licheegh/LCSDR/README.md

# LCSDR

more at <http://www.squirrel-electronics.com/lcsdrgong-cheng.html>
