licheegh/LCSDR/hardware/main/bom.ods

Qty | Reference(s) | Footprint | LibPart | Value | Source
24 | C201, C202, C208, C210, C211, C212, C213, C214, C215, C305, C306, C307, C317, C325, C402, C406, C407, C414, C415, C505, C511, C514, C516, C518 | Resistors_SMD:R_0805 | device:C | 4.7u
11 | C203, C204, C205, C206, C207, C222, C223, C411, C412, C416, C422 | Capacitors_SMD:C_1206 | device:C | 22u
57 | C209, C216, C217, C218, C219, C220, C221, C224, C225, C226, C227, C228, C229, C230, C301, C302, C303, C304, C308, C309, C310, C311, C314, C316, C318, C319, C320, C321, C322, C323, C324, C401, C403, C404, C405, C408, C413, C419, C423, C424, C501, C507, C508, C509, C510, C512, C513, C515, C517, C519, C520, C521, C522, C523, C524, C525, C526 | Capacitors_SMD:C_0402 | device:C | 0.47u
2 | C409, C410 | Capacitors_SMD:c_elec_6.3x5.8 | device:CP | 47u
2 | C420, C421 | Resistors_SMD:R_0805 | device:C | 0.1u
2 | C502, C503 | Resistors_SMD:R_0805 | device:C | 12p
2 | C504, C527 | Capacitors_SMD:C_1206 | device:C | 4.7n 250V
1 | C506 | Capacitors_Elko_ThroughHole:Elko_vert_11.5x8mm_RM3.5 | device:CP | 470u
2 | D201, D202 | Diodes_SMD:SMA_Standard | device:D_Schottky | D_Schottky
4 | D301, D401, D502, D503 | LEDs:LED-0805 | device:LED | LED
1 | D501 | Diodes_SMD:SMA_Standard | device:TVS | TVS
1 | DD501 | Housings_SSOP:SSOP-56_7.5x18.5mm_Pitch0.635mm | active_components_lib:IC_CY7C68013A | IC_CY7C68013A
3 | FB201, FB202, FB501 | Resistors_SMD:R_0805 | device:FILTER | FILTER
4 | FB401, FB402, FB403, FB502 | Resistors_SMD:R_0805 | device:FILTER | FB
1 | J1 | my:5PIN_3.5mm_Audio_Jack_Wide | my:JACK_TRS_5PINS | JACK_TRS_5PINS
3 | JP501, JP502, JP503 | Pin_Headers:Pin_Header_Straight_1x02 | device:JUMPER | JUMPER
2 | L201, L202 | Choke_SMD:Choke_SMD_6.3x6.3_H3 | device:INDUCTOR | INDUCTOR
4 | M401, M402, M403, M404 | my:Mounting_Hole_3mm | my:Mount_Hole | Mount_Hole
1 | P401 | Socket_Strips:Socket_Strip_Straight_2x07 | conn:CONN_02X07 | CONN_02X07
1 | P402 | Socket_Strips:Socket_Strip_Angled_2x13 | conn:CONN_02X13 | CONN_02X13
2 | P501, P502 | my:USB_Micro-B | conn:USB_OTG | USB_OTG
8 | R201, R202, R301, R302, R303, R502, R503, R506 | Resistors_SMD:R_0805 | device:R | 100k
6 | R203, R204, R205, R206, R504, R505 | Resistors_SMD:R_0805 | device:R | 10k
13 | R207, R208, R210, R211, R304, R402, R403, R404, R406, R407, R408, R409, R412 | Resistors_SMD:R_0402 | device:R | 0
5 | R305, R307, R308, R309, R310 | Resistors_SMD:R_0805 | device:R | 2.4k
5 | R306, R401, R510, R511, R513 | Resistors_SMD:R_0805 | device:R | 560
1 | R405 | Resistors_SMD:R_0805 | device:R | 50
2 | R410, R411 | Resistors_SMD:R_0805 | device:R | 4.7
3 | R501, R512, R514 | Resistors_SMD:R_0805 | device:R | 1Meg
2 | R507, R508 | Resistors_SMD:R_0805 | device:R | 2.2k
1 | R509 | Resistors_SMD:R_0805 | device:R | 20k
1 | RV401 | my:RK09L12 | my:DUAL_POT_WITH_SHIELD | DUAL_POT_WITH_SHIELD
1 | S401 | my:EC11B15242A | my:Encoder_with_swith | Encoder_with_swith
2 | SW401, SW501 | my:SW_SPST_FSMSM | device:SW_PUSH | SW_PUSH
2 | U201, U202 | TO_SOT_Packages_SMD:SOT-23-5 | my:LMR10515-SOT23 | LMR10515-SOT23
1 | U203 | my:BGA-256_pitch1mm_dia0.4mm | xilinx-spartan6:XC6SLX25-FTG256 | XC6SLX25-FTG256
2 | U204, U205 | TO_SOT_Packages_SMD:SOT-223 | my:General_SOT223_LDO | General_SOT223_LDO
1 | U301 | Housings_QFP:LQFP-64_7x7mm_Pitch0.4mm | my:AD92x8 | AD92x8
1 | U302 | Housings_SOIC:SOIJ-8_5.3x5.3mm_Pitch1.27mm | my:25_Serial_Flash_8_Pin | 25_Serial_Flash_8_Pin
3 | U401, U402, U403 | TO_SOT_Packages_SMD:SOT-23-5 | 74xx:74AHC1G04 | 74AHC1G04
1 | U404 | Housings_SSOP:SSOP-16_4.4x5.2mm_Pitch0.65mm | my:UDA1334 | UDA1334
1 | U405 | Housings_DIP:DIP-8_W7.62mm | my:TDA2822M | TDA2822M
1 | U406 | Housings_SOIC:SOIC-8_3.9x4.9mm_Pitch1.27mm | my:MCP3202 | MCP3202
1 | U407 | Housings_SOIC:SOIC-8_3.9x4.9mm_Pitch1.27mm | my:MCP48x2 | MCP48x2
1 | U501 | Housings_SOIC:SOIC-8_3.9x4.9mm_Pitch1.27mm | memory:24C16 | 24C16
1 | X401 | my:oscillator_4Pin_5032_7050 | my:4-Pin_Oscillator | 4-Pin_Oscillator
1 | Y501 | Crystals:Crystal_HC49-U_Vertical | device:Crystal | Crystal
