licheegh/LCSDR/hardware/main/main.kicad_pcb

## KiCad design hardware/main/main.kicad_pcb (2015-11-01)

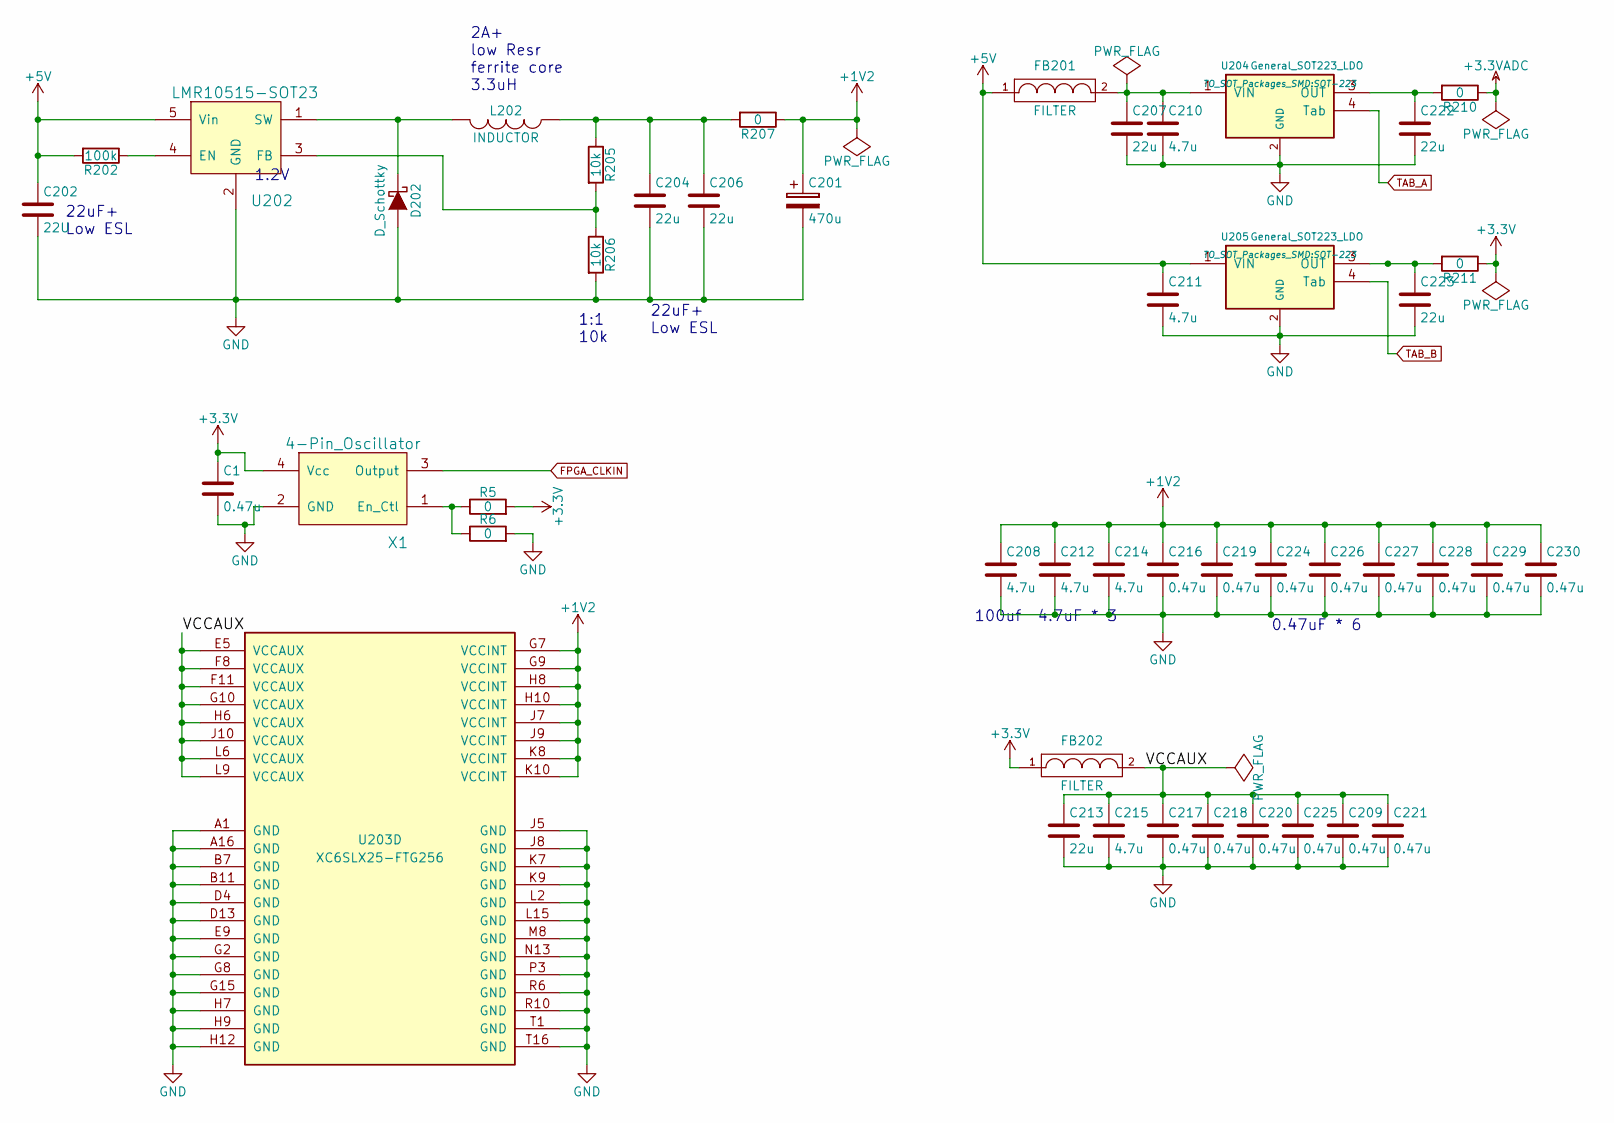
[picture p1: schematic PSU.sch]

Parts:
C1, C209, C216, C217, C218, C219, C220, C221, C224, C225, C226, C227, C228, C229, C230: 0.47u; C_0402
C201: 470u; Elko_vert_11.5x8mm_RM3.5
C202: 22U; C_1206
C204, C206, C207, C213, C222, C223: 22u; C_1206
C208, C210, C211, C212, C214, C215: 4.7u; R_0805
D202: D_Schottky; SMB_Standard
FB201, FB202: FILTER; R_0805
L202: INDUCTOR; Choke_SMD_6.3x6.3_H3
R5, R6: 0; R_0402
R202: 100k; R_0805
R205, R206: 10k; R_0805
R207, R210, R211: 0; R_0805
U202: LMR10515-SOT23; SOT-23-5
U203: XC6SLX25-FTG256; BGA-256_pitch1mm_dia0.4mm
U204, U205: General_SOT223_LDO; SOT-223
X1: 4-Pin_Oscillator; oscillator_4Pin_5032_7050

Connections:
+1V2: C201.1, C208.1, C212.1, C214.1, C216.1, C219.1, C224.1, C226.1, C227.1, C228.1, C229.1, C230.1, R207.1, U203.G7 (VCCINT), U203.G9 (VCCINT), U203.H8 (VCCINT), U203.H10 (VCCINT), U203.J7 (VCCINT), U203.J9 (VCCINT), U203.K8 (VCCINT), U203.K10 (VCCINT)
+3.3VADC: R210.1; also elsewhere on the board
+3V3: C1.1, FB202.1, R5.2, R211.1, X1.4 (Vcc); also elsewhere on the board
+5V: C202.1, C211.1, FB201.1, R202.2, U202.5 (Vin), U205.1 (VIN); also elsewhere on the board
/PSU/VCCAUX: C209.1, C213.1, C215.1, C217.1, C218.1, C220.1, C221.1, C225.1, FB202.2, U203.E5 (VCCAUX), U203.F8 (VCCAUX), U203.F11 (VCCAUX), U203.G10 (VCCAUX), U203.H6 (VCCAUX), U203.J10 (VCCAUX), U203.L6 (VCCAUX), U203.L9 (VCCAUX)
FPGA_CLKIN: X1.3 (Output); also elsewhere on the board
GND: C1.2, C201.2, C202.2, C204.2, C206.2, C207.2, C208.2, C209.2, C210.2, C211.2, C212.2, C213.2, C214.2, C215.2, C216.2, C217.2, C218.2, C219.2, C220.2, C221.2, C222.2, C223.2, C224.2, C225.2, C226.2, C227.2, C228.2, C229.2, C230.2, D202.2 (A), R6.2, R206.2, U202.2 (GND), U203.A1 (GND), U203.A16 (GND), U203.B7 (GND), U203.B11 (GND), U203.D4 (GND), U203.D13 (GND), U203.E9 (GND), U203.G2 (GND), U203.G8 (GND), U203.G15 (GND), U203.H7 (GND), U203.H9 (GND), U203.H12 (GND), U203.J5 (GND), U203.J8 (GND), U203.K7 (GND), U203.K9 (GND), U203.L2 (GND), U203.L15 (GND), U203.M8 (GND), U203.N13 (GND), U203.P3 (GND), U203.R6 (GND), U203.R10 (GND), U203.T1 (GND), U203.T16 (GND), U204.2 (GND), U205.2 (GND), X1.2 (GND); also elsewhere on the board
unnamed: C204.1, C206.1, L202.1, R205.1, R207.2
unnamed: C207.1, C210.1, FB201.2, U204.1 (VIN)
unnamed: C222.1, R210.2, U204.3 (OUT)
unnamed: C223.1, R211.2, U205.3 (OUT)
unnamed: D202.1 (K), L202.2, U202.1 (SW)
unnamed: R5.1, R6.1, X1.1 (En_Ctl)
unnamed: R202.1, U202.4 (EN)
unnamed: R205.2, R206.1, U202.3 (FB)
TAB_A: U204.4 (Tab)
TAB_B: U205.4 (Tab)

Notes on the sheet:
1.2V
2A+ low Resr ferrite core 3.3uH
22uF+ Low ESL
1:1 10k
100uf
4.7uF * 3
0.47uF * 6

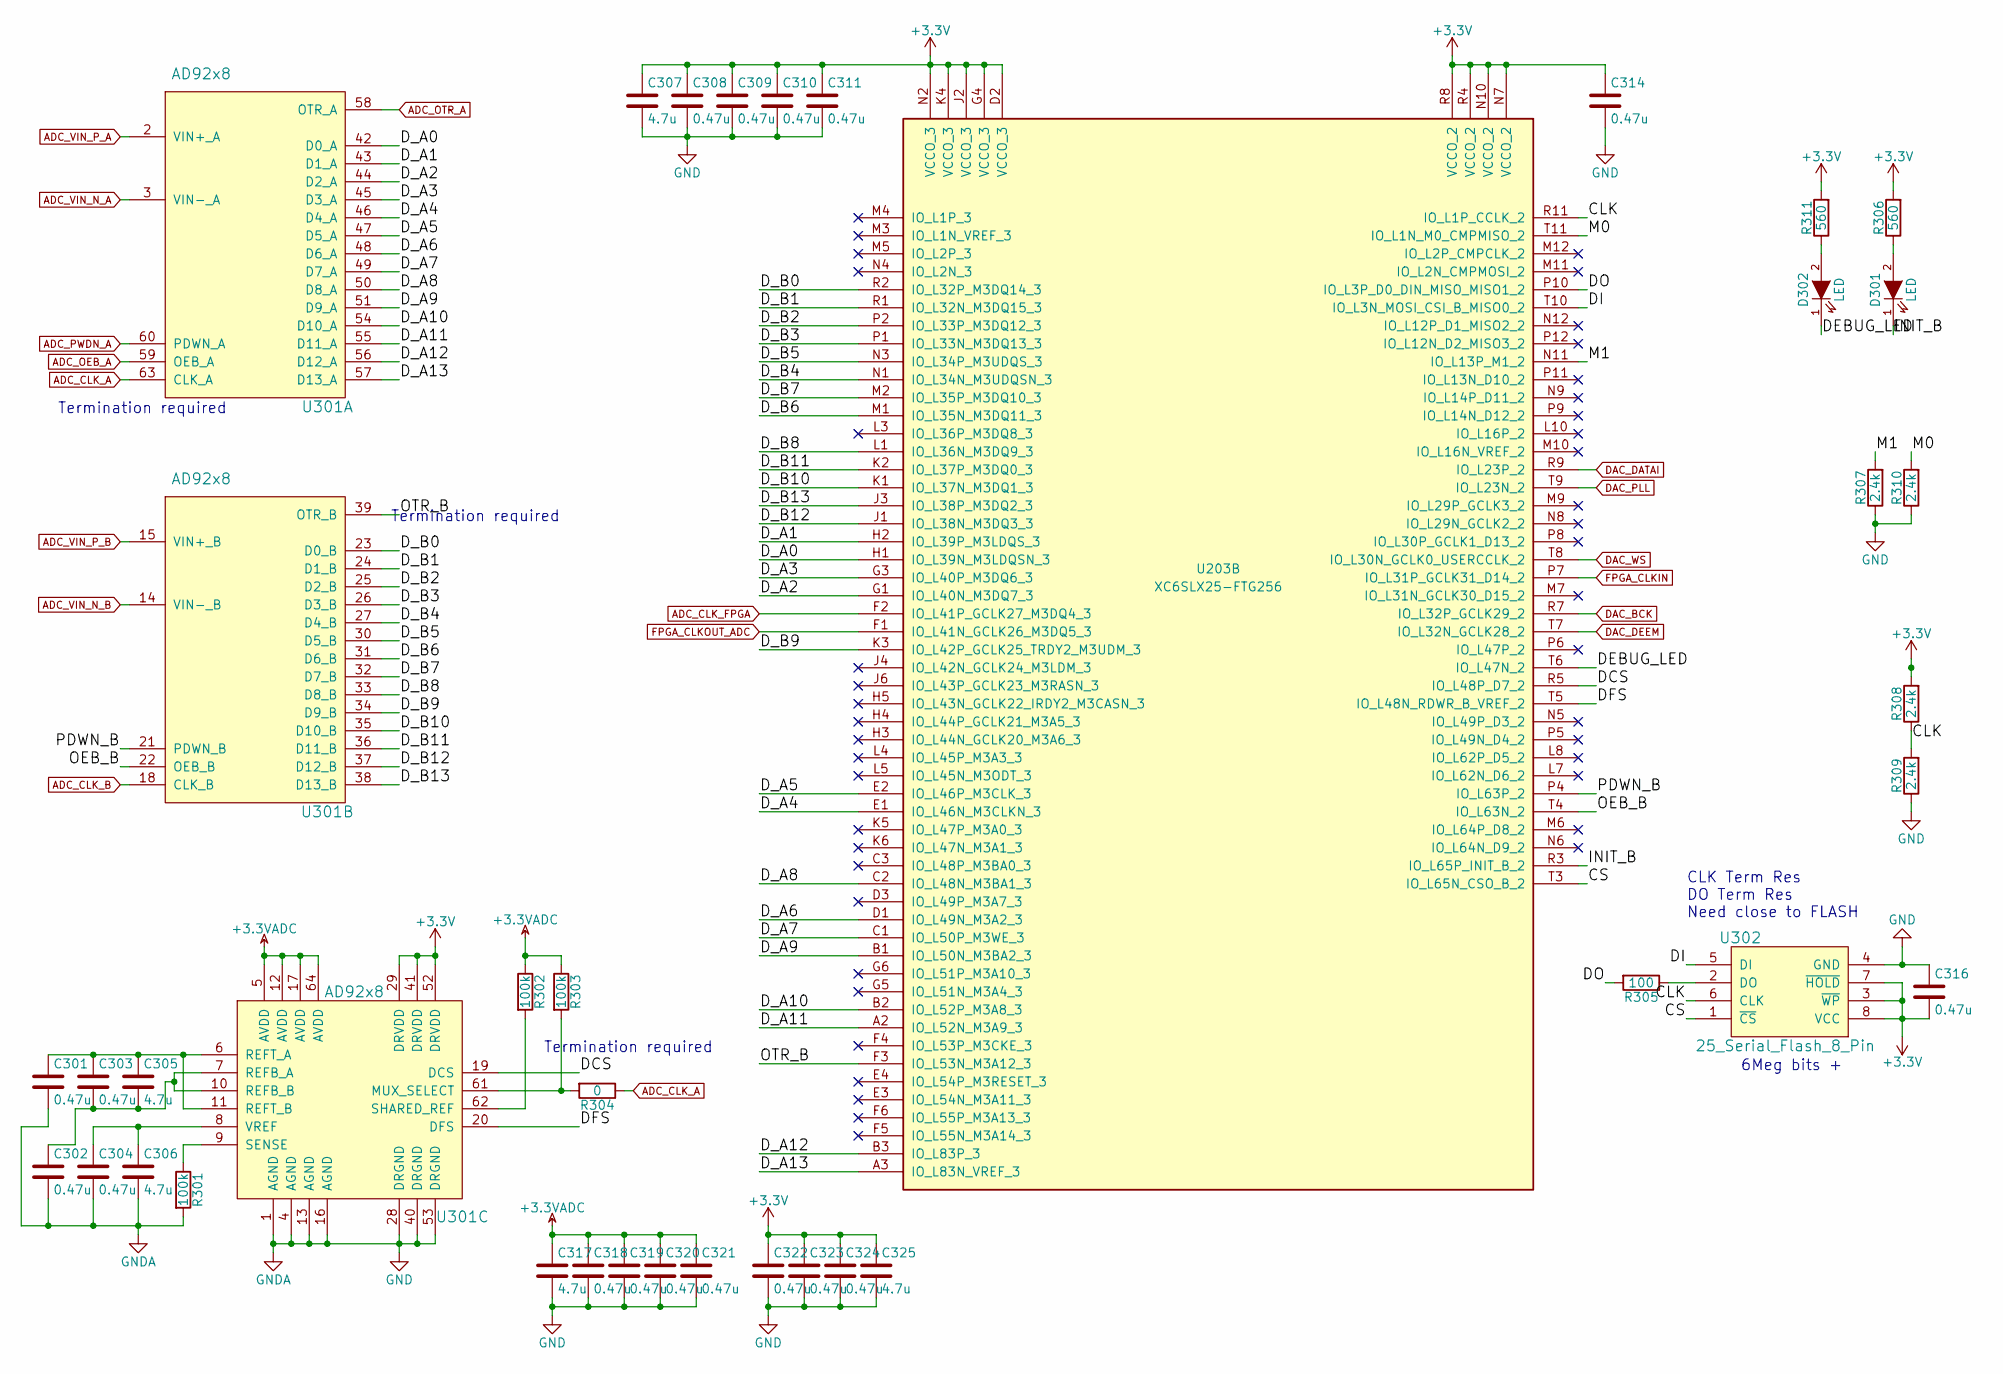
[picture p2: schematic ADC.sch]

Parts:
C301, C302, C303, C304, C308, C309, C310, C311, C314, C316, C318, C319, C320, C321, C322, C323, C324: 0.47u; C_0402
C305, C306, C307, C317, C325: 4.7u; R_0805
D301, D302: LED; LED-0805
R301, R302, R303: 100k; R_0805
R304: 0; R_0402
R305: 100; R_0805
R306, R311: 560; R_0805
R307, R308, R309, R310: 2.4k; R_0805
U203: XC6SLX25-FTG256; BGA-256_pitch1mm_dia0.4mm
U301: AD92x8; LQFP-64_7x7mm_Pitch0.4mm
U302: 25_Serial_Flash_8_Pin; SOIJ-8_5.3x5.3mm_Pitch1.27mm

Connections:
+3.3VADC: C317.1, C318.1, C319.1, C320.1, C321.1, R302.1, R303.1, U301.5 (AVDD), U301.12 (AVDD), U301.17 (AVDD), U301.64 (AVDD); also elsewhere on the board
+3V3: C307.1, C308.1, C309.1, C310.1, C311.1, C314.1, C316.2, C322.1, C323.1, C324.1, C325.1, R306.2, R308.2, R311.2, U203.D2 (VCCO_3), U203.G4 (VCCO_3), U203.J2 (VCCO_3), U203.K4 (VCCO_3), U203.N2 (VCCO_3), U203.N7 (VCCO_2), U203.N10 (VCCO_2), U203.R4 (VCCO_2), U203.R8 (VCCO_2), U301.29 (DRVDD), U301.41 (DRVDD), U301.52 (DRVDD), U302.3 (~WP), U302.7 (~HOLD), U302.8 (VCC); also elsewhere on the board
/ADC/CLK: R308.1, R309.2, U203.R11 (IO_L1P_CCLK_2), U302.6 (CLK)
/ADC/CS: U203.T3 (IO_L65N_CSO_B_2), U302.1 (~CS)
/ADC/DCS: U203.R5 (IO_L48P_D7_2), U301.19 (DCS)
/ADC/DEBUG_LED: D302.1 (K), U203.T6 (IO_L47N_2)
/ADC/DFS: U203.T5 (IO_L48N_RDWR_B_VREF_2), U301.20 (DFS)
/ADC/DI: U203.T10 (IO_L3N_MOSI_CSI_B_MISO0_2), U302.5 (DI)
/ADC/DO: R305.2, U203.P10 (IO_L3P_D0_DIN_MISO_MISO1_2)
/ADC/D_A0: U203.H1 (IO_L39N_M3LDQSN_3), U301.42 (D0_A)
/ADC/D_A1: U203.H2 (IO_L39P_M3LDQS_3), U301.43 (D1_A)
/ADC/D_A2: U203.G1 (IO_L40N_M3DQ7_3), U301.44 (D2_A)
/ADC/D_A3: U203.G3 (IO_L40P_M3DQ6_3), U301.45 (D3_A)
/ADC/D_A4: U203.E1 (IO_L46N_M3CLKN_3), U301.46 (D4_A)
/ADC/D_A5: U203.E2 (IO_L46P_M3CLK_3), U301.47 (D5_A)
/ADC/D_A6: U203.D1 (IO_L49N_M3A2_3), U301.48 (D6_A)
/ADC/D_A7: U203.C1 (IO_L50P_M3WE_3), U301.49 (D7_A)
/ADC/D_A8: U203.C2 (IO_L48N_M3BA1_3), U301.50 (D8_A)
/ADC/D_A9: U203.B1 (IO_L50N_M3BA2_3), U301.51 (D9_A)
/ADC/D_A10: U203.B2 (IO_L52P_M3A8_3), U301.54 (D10_A)
/ADC/D_A11: U203.A2 (IO_L52N_M3A9_3), U301.55 (D11_A)
/ADC/D_A12: U203.B3 (IO_L83P_3), U301.56 (D12_A)
/ADC/D_A13: U203.A3 (IO_L83N_VREF_3), U301.57 (D13_A)
/ADC/D_B0: U203.R2 (IO_L32P_M3DQ14_3), U301.23 (D0_B)
/ADC/D_B1: U203.R1 (IO_L32N_M3DQ15_3), U301.24 (D1_B)
/ADC/D_B2: U203.P2 (IO_L33P_M3DQ12_3), U301.25 (D2_B)
/ADC/D_B3: U203.P1 (IO_L33N_M3DQ13_3), U301.26 (D3_B)
/ADC/D_B4: U203.N1 (IO_L34N_M3UDQSN_3), U301.27 (D4_B)
/ADC/D_B5: U203.N3 (IO_L34P_M3UDQS_3), U301.30 (D5_B)
/ADC/D_B6: U203.M1 (IO_L35N_M3DQ11_3), U301.31 (D6_B)
/ADC/D_B7: U203.M2 (IO_L35P_M3DQ10_3), U301.32 (D7_B)
/ADC/D_B8: U203.L1 (IO_L36N_M3DQ9_3), U301.33 (D8_B)
/ADC/D_B9: U203.K3 (IO_L42P_GCLK25_TRDY2_M3UDM_3), U301.34 (D9_B)
/ADC/D_B10: U203.K1 (IO_L37N_M3DQ1_3), U301.35 (D10_B)
/ADC/D_B11: U203.K2 (IO_L37P_M3DQ0_3), U301.36 (D11_B)
/ADC/D_B12: U203.J1 (IO_L38N_M3DQ3_3), U301.37 (D12_B)
/ADC/D_B13: U203.J3 (IO_L38P_M3DQ2_3), U301.38 (D13_B)
/ADC/INIT_B: D301.1 (K), U203.R3 (IO_L65P_INIT_B_2)
/ADC/M0: R310.2, U203.T11 (IO_L1N_M0_CMPMISO_2)
/ADC/M1: R307.2, U203.N11 (IO_L13P_M1_2)
/ADC/OEB_B: U203.T4 (IO_L63N_2), U301.22 (OEB_B)
/ADC/OTR_B: U203.F3 (IO_L53N_M3A12_3), U301.39 (OTR_B)
/ADC/PDWN_B: U203.P4 (IO_L63P_2), U301.21 (PDWN_B)
ADC_CLK_A: R304.1, U301.63 (CLK_A); also elsewhere on the board
ADC_CLK_B: U301.18 (CLK_B); also elsewhere on the board
ADC_CLK_FPGA: U203.F2 (IO_L41P_GCLK27_M3DQ4_3); also elsewhere on the board
ADC_OEB_A: U301.59 (OEB_A); also elsewhere on the board
ADC_OTR_A: U301.58 (OTR_A); also elsewhere on the board
ADC_PWDN_A: U301.60 (PDWN_A); also elsewhere on the board
ADC_VIN_N_A: U301.3 (VIN-_A); also elsewhere on the board
ADC_VIN_N_B: U301.14 (VIN-_B); also elsewhere on the board
ADC_VIN_P_A: U301.2 (VIN+_A); also elsewhere on the board
ADC_VIN_P_B: U301.15 (VIN+_B); also elsewhere on the board
DAC_BCK: U203.R7 (IO_L32P_GCLK29_2); also elsewhere on the board
DAC_DATAI: U203.R9 (IO_L23P_2); also elsewhere on the board
DAC_DEEM: U203.T7 (IO_L32N_GCLK28_2); also elsewhere on the board
DAC_PLL: U203.T9 (IO_L23N_2); also elsewhere on the board
DAC_WS: U203.T8 (IO_L30N_GCLK0_USERCCLK_2); also elsewhere on the board
FPGA_CLKIN: U203.P7 (IO_L31P_GCLK31_D14_2); also elsewhere on the board
FPGA_CLKOUT_ADC: U203.F1 (IO_L41N_GCLK26_M3DQ5_3); also elsewhere on the board
GND: C301.2, C302.2, C304.2, C306.2, C307.2, C308.2, C309.2, C310.2, C311.2, C314.2, C316.1, C317.2, C318.2, C319.2, C320.2, C321.2, C322.2, C323.2, C324.2, C325.2, R301.2, R307.1, R309.1, R310.1, U301.1 (AGND), U301.4 (AGND), U301.13 (AGND), U301.16 (AGND), U301.28 (DRGND), U301.40 (DRGND), U301.53 (DRGND), U302.4 (GND); also elsewhere on the board
unnamed: C301.1, C303.1, C305.1, U301.6 (REFT_A), U301.11 (REFT_B)
unnamed: C302.1, C303.2, C305.2, U301.7 (REFB_A), U301.10 (REFB_B)
unnamed: C304.1, C306.1, U301.8 (VREF)
unnamed: D301.2 (A), R306.1
unnamed: D302.2 (A), R311.1
unnamed: R301.1, U301.9 (SENSE)
unnamed: R302.2, U301.62 (SHARED_REF)
unnamed: R303.2, R304.2, U301.61 (MUX_SELECT)
unnamed: R305.1, U302.2 (DO)

Notes on the sheet:
Termination required
6Meg bits +
CLK Term Res DO Term Res Need close to FLASH

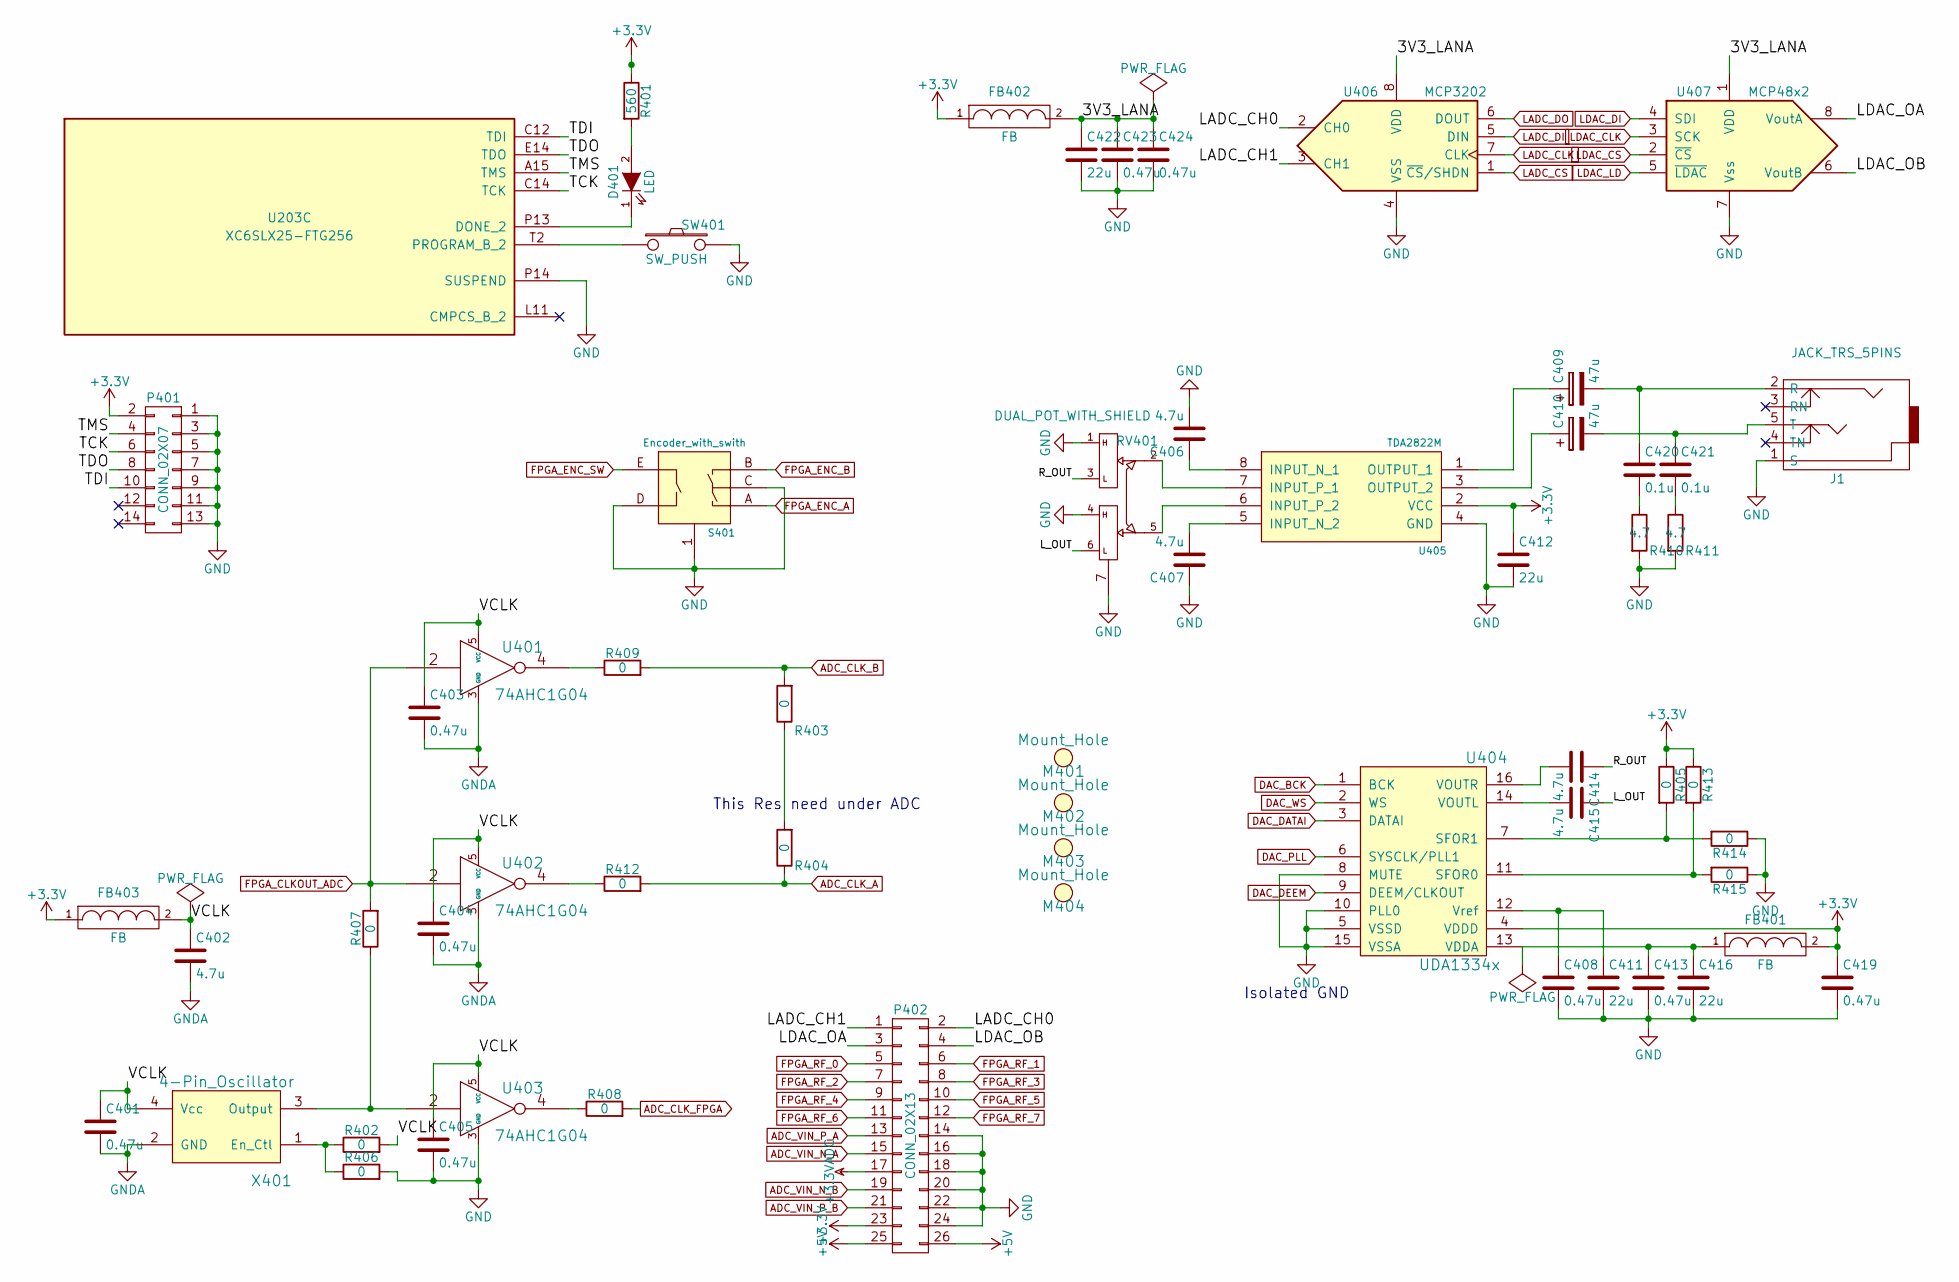
[picture p3: schematic etc.sch]

Parts:
C401, C403, C404, C405, C408, C413, C419, C423, C424: 0.47u; C_0402
C402, C406, C407, C414, C415: 4.7u; R_0805
C409, C410: 47u; c_elec_6.3x5.8
C411, C412, C416, C422: 22u; C_1206
C420, C421: 0.1u; R_0805
D401: LED; LED-0805
FB401, FB402, FB403: FB; R_0805
J1: JACK_TRS_5PINS; 5PIN_3.5mm_Audio_Jack_Wide
M401, M402, M403, M404: Mount_Hole; Mounting_Hole_3mm
P401: CONN_02X07; Socket_Strip_Straight_2x07
P402: CONN_02X13; Socket_Strip_Straight_2x13
R401: 560; R_0805
R402, R403, R404, R405, R406, R407, R408, R409, R412, R413, R414, R415: 0; R_0402
R410, R411: 4.7; R_0805
RV401: DUAL_POT_WITH_SHIELD; RK09L12
S401: Encoder_with_swith; EC11B15242A
SW401: SW_PUSH; SW_SPST_FSMSM
U203: XC6SLX25-FTG256; BGA-256_pitch1mm_dia0.4mm
U401, U402, U403: 74AHC1G04; SOT-23-5
U404: UDA1334x; SSOP-16_4.4x5.2mm_Pitch0.65mm
U405: TDA2822M; DIP-8_W7.62mm
U406: MCP3202; SOIC-8_3.9x4.9mm_Pitch1.27mm
U407: MCP48x2; SOIC-8_3.9x4.9mm_Pitch1.27mm
X401: 4-Pin_Oscillator; oscillator_4Pin_5032_7050

Connections:
+3.3VADC: P402.17; also elsewhere on the board
+3V3: C412.1, C419.1, FB401.2, FB402.1, FB403.1, P401.2, P402.23, R401.1, R405.1, R413.1, U404.4 (VDDD), U405.2 (VCC); also elsewhere on the board
+5V: P402.25, P402.26; also elsewhere on the board
/etc/3V3_LANA: C422.1, C423.1, C424.1, FB402.2, U406.8 (VDD), U407.1 (VDD)
/etc/LADC_CH0: P402.2, U406.2 (CH0)
/etc/LADC_CH1: P402.1, U406.3 (CH1)
/etc/LDAC_OA: P402.3, U407.8 (VoutA)
/etc/LDAC_OB: P402.4, U407.6 (VoutB)
/etc/L_OUT: C415.1, RV401.6
/etc/R_OUT: C414.1, RV401.3
/etc/TCK: P401.6, U203.C14 (TCK)
/etc/TDI: P401.10, U203.C12 (TDI)
/etc/TDO: P401.8, U203.E14 (TDO)
/etc/TMS: P401.4, U203.A15 (TMS)
/etc/VCLK: C401.1, C402.1, C403.1, C404.1, C405.1, FB403.2, R402.2, U401.5 (VCC), U402.5 (VCC), U403.5 (VCC), X401.4 (Vcc)
ADC_CLK_A: R404.1, R412.2; also elsewhere on the board
ADC_CLK_B: R403.2, R409.2; also elsewhere on the board
ADC_CLK_FPGA: R408.2; also elsewhere on the board
ADC_VIN_N_A: P402.15; also elsewhere on the board
ADC_VIN_N_B: P402.19; also elsewhere on the board
ADC_VIN_P_A: P402.13; also elsewhere on the board
ADC_VIN_P_B: P402.21; also elsewhere on the board
DAC_BCK: U404.1 (BCK); also elsewhere on the board
DAC_DATAI: U404.3 (DATAI); also elsewhere on the board
DAC_DEEM: U404.9 (DEEM/CLKOUT); also elsewhere on the board
DAC_PLL: U404.6 (SYSCLK/PLL1); also elsewhere on the board
DAC_WS: U404.2 (WS); also elsewhere on the board
FPGA_CLKOUT_ADC: R407.2, U401.2, U402.2; also elsewhere on the board
FPGA_ENC_A: S401.A; also elsewhere on the board
FPGA_ENC_B: S401.B; also elsewhere on the board
FPGA_ENC_SW: S401.E; also elsewhere on the board
FPGA_RF_0: P402.5; also elsewhere on the board
FPGA_RF_1: P402.6; also elsewhere on the board
FPGA_RF_2: P402.7; also elsewhere on the board
FPGA_RF_3: P402.8; also elsewhere on the board
FPGA_RF_4: P402.9; also elsewhere on the board
FPGA_RF_5: P402.10; also elsewhere on the board
FPGA_RF_6: P402.11; also elsewhere on the board
FPGA_RF_7: P402.12; also elsewhere on the board
GND: C401.2, C402.2, C403.2, C404.2, C405.2, C406.2, C407.1, C408.2, C411.2, C412.2, C413.2, C416.2, C419.2, C422.2, C423.2, C424.2, J1.1 (S), P401.1, P401.3, P401.5, P401.7, P401.9, P401.11, P401.13, P402.14, P402.16, P402.18, P402.20, P402.22, P402.24, R406.2, R410.2, R411.2, R414.1, R415.1, RV401.1, RV401.4, RV401.7 (Shield), S401.1, S401.C, S401.D, SW401.2, U203.P14 (SUSPEND), U401.3 (GND), U402.3 (GND), U403.3 (GND), U404.5 (VSSD), U404.8 (MUTE), U404.10 (PLL0), U404.15 (VSSA), U405.4 (GND), U406.4 (VSS), U407.7 (Vss), X401.2 (GND); also elsewhere on the board
LADC_CLK: U406.7 (CLK); also elsewhere on the board
LADC_CS: U406.1 (~CS~/SHDN); also elsewhere on the board
LADC_DI: U406.5 (DIN); also elsewhere on the board
LADC_DO: U406.6 (DOUT); also elsewhere on the board
LDAC_CLK: U407.3 (SCK); also elsewhere on the board
LDAC_CS: U407.2 (~CS~); also elsewhere on the board
LDAC_DI: U407.4 (SDI); also elsewhere on the board
LDAC_LD: U407.5 (~LDAC~); also elsewhere on the board
unnamed: C406.1, U405.8 (INPUT_N_1)
unnamed: C407.2, U405.5 (INPUT_N_2)
unnamed: C408.1, C411.1, U404.12 (Vref)
unnamed: C409.1, U405.1 (OUTPUT_1)
unnamed: C409.2, C420.1, J1.2 (R)
unnamed: C410.1, U405.3 (OUTPUT_2)
unnamed: C410.2, C421.1, J1.5 (T)
unnamed: C413.1, C416.1, FB401.1, U404.13 (VDDA)
unnamed: C414.2, U404.16 (VOUTR)
unnamed: C415.2, U404.14 (VOUTL)
unnamed: C420.2, R410.1
unnamed: C421.2, R411.1
unnamed: D401.1 (K), U203.P13 (DONE_2)
unnamed: D401.2 (A), R401.2
unnamed: R402.1, R406.1, X401.1 (En_Ctl)
unnamed: R403.1, R404.2
unnamed: R405.2, R414.2, U404.7 (SFOR1)
unnamed: R407.1, U403.2, X401.3 (Output)
unnamed: R408.1, U403.4
unnamed: R409.1, U401.4
unnamed: R412.1, U402.4
unnamed: R413.2, R415.2, U404.11 (SFOR0)
unnamed: RV401.2, U405.7 (INPUT_P_1)
unnamed: RV401.5, U405.6 (INPUT_P_2)
unnamed: SW401.1, U203.T2 (PROGRAM_B_2)

Notes on the sheet:
Isolated GND
This Res need under ADC

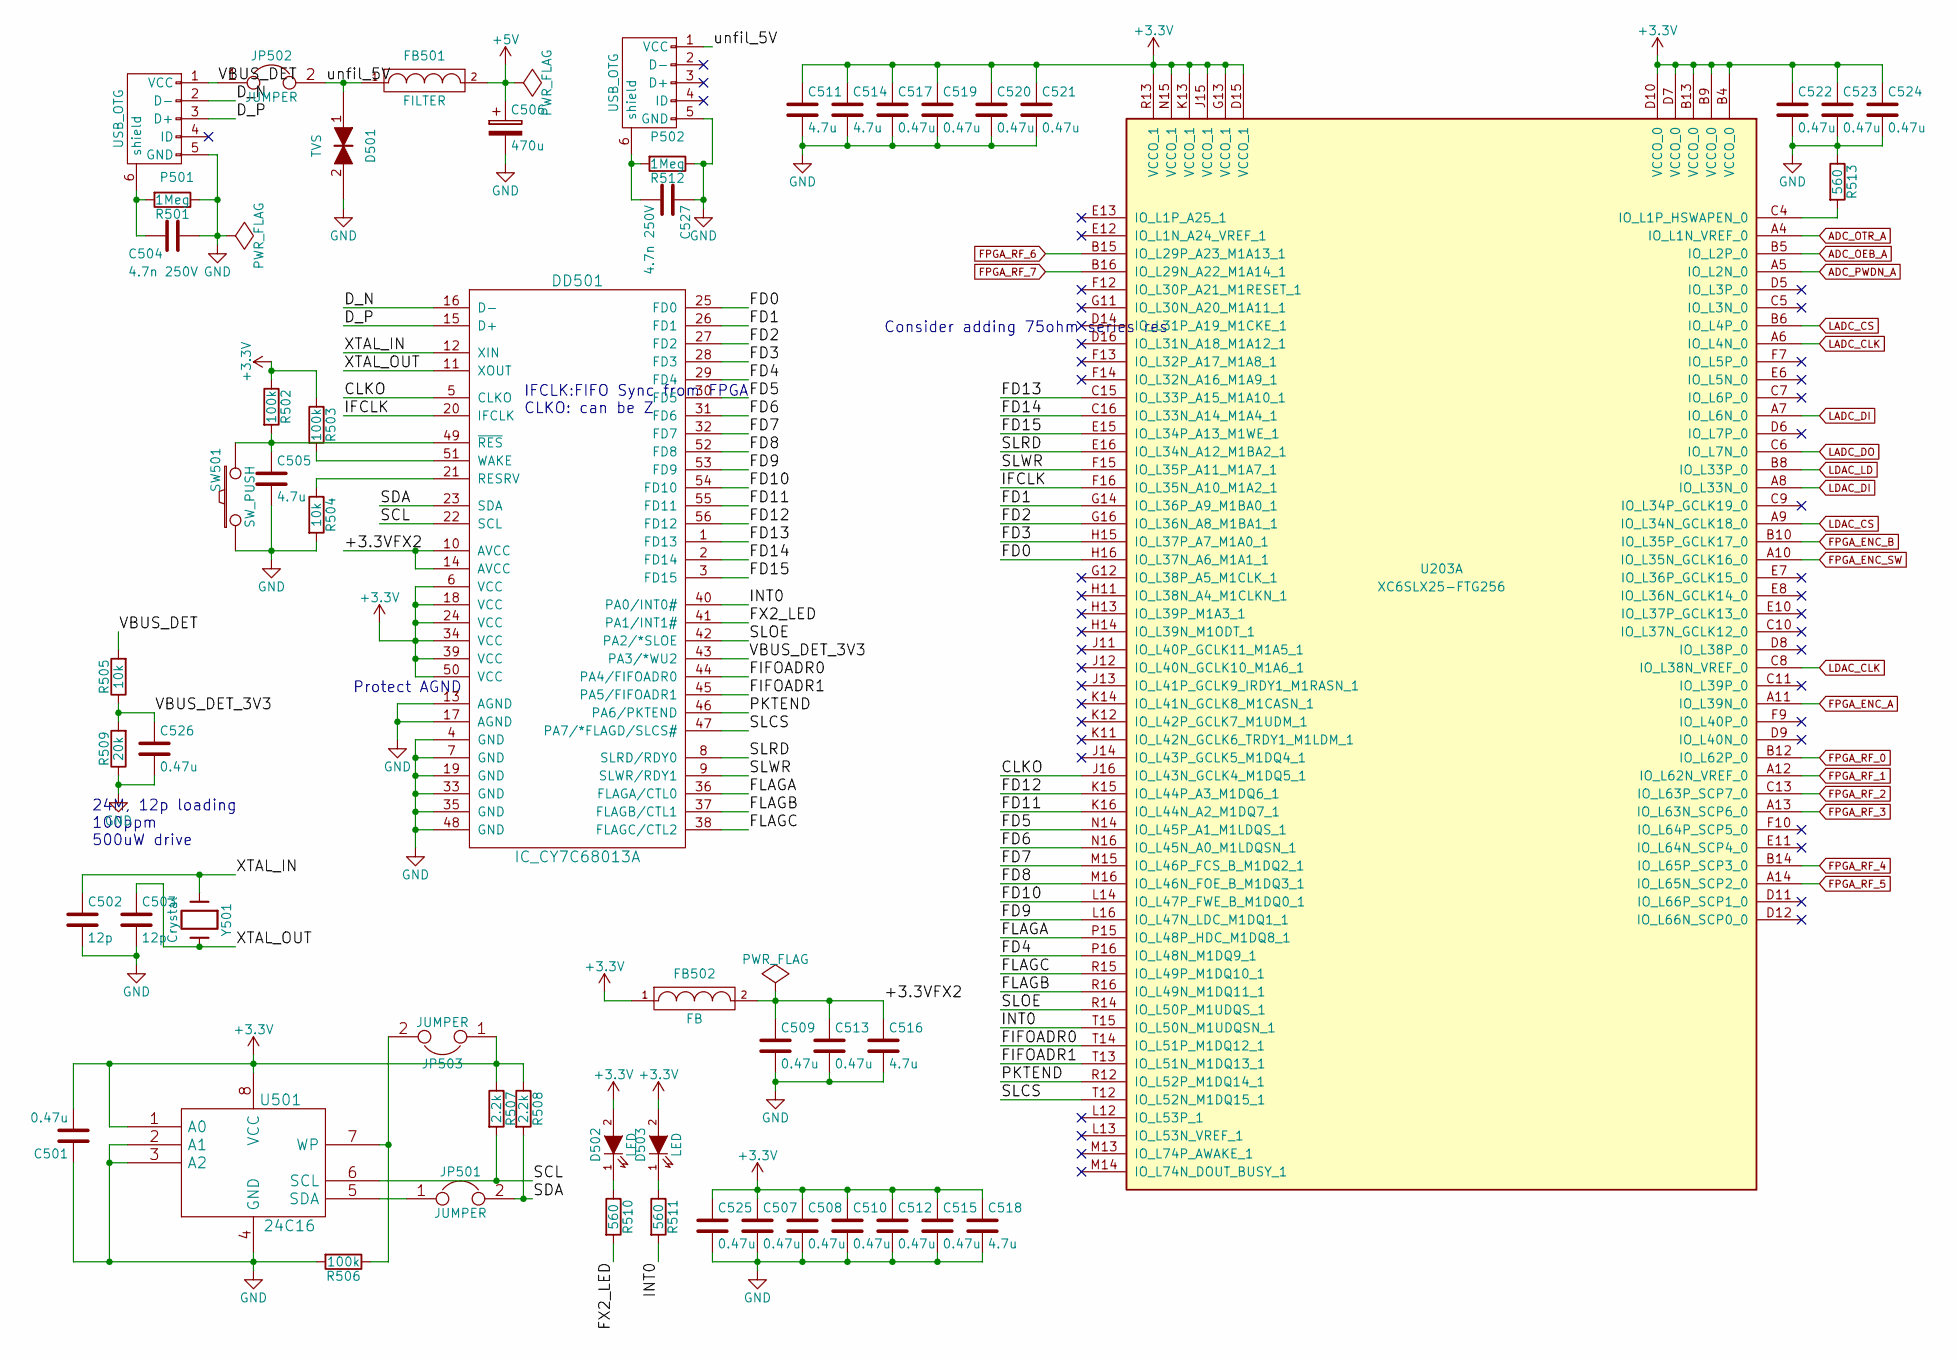
[picture p4: schematic USB.sch]

Parts:
C501, C507, C508, C509, C510, C512, C513, C515, C517, C519, C520, C521, C522, C523, C524, C525, C526: 0.47u; C_0402
C502, C503: 12p; R_0805
C504, C527: 4.7n 250V; C_1206
C505, C511, C514, C516, C518: 4.7u; R_0805
C506: 470u; Elko_vert_11.5x8mm_RM3.5
D501: TVS; SMA_Standard
D502, D503: LED; LED-0805
DD501: IC_CY7C68013A; SSOP-56_7.5x18.5mm_Pitch0.635mm
FB501: FILTER; R_0805
FB502: FB; R_0805
JP501, JP502, JP503: JUMPER; Pin_Header_Straight_1x02
P501, P502: USB_OTG; USB_Micro-B
R501, R512: 1Meg; R_0805
R502, R503, R506: 100k; R_0805
R504, R505: 10k; R_0805
R507, R508: 2.2k; R_0805
R509: 20k; R_0805
R510, R511, R513: 560; R_0805
SW501: SW_PUSH; SW_SPST_FSMSM
U203: XC6SLX25-FTG256; BGA-256_pitch1mm_dia0.4mm
U501: 24C16; SOIC-8_3.9x4.9mm_Pitch1.27mm
Y501: Crystal; Crystal_HC49-U_Vertical

Connections:
+3V3: C501.2, C507.1, C508.1, C510.1, C511.1, C512.1, C514.1, C515.1, C517.1, C518.1, C519.1, C520.1, C521.1, C522.1, C523.1, C524.1, C525.1, D502.2 (A), D503.2 (A), DD501.6 (VCC), DD501.18 (VCC), DD501.24 (VCC), DD501.34 (VCC), DD501.39 (VCC), DD501.50 (VCC), FB502.1, JP503.1, R502.1, R503.1, R507.1, R508.1, U203.B4 (VCCO_0), U203.B9 (VCCO_0), U203.B13 (VCCO_0), U203.D7 (VCCO_0), U203.D10 (VCCO_0), U203.D15 (VCCO_1), U203.G13 (VCCO_1), U203.J15 (VCCO_1), U203.K13 (VCCO_1), U203.N15 (VCCO_1), U203.R13 (VCCO_1), U501.1 (A0), U501.8 (VCC); also elsewhere on the board
+5V: C506.1, FB501.2; also elsewhere on the board
/USB/+3.3VFX2: C509.1, C513.1, C516.1, DD501.10 (AVCC), DD501.14 (AVCC), FB502.2
/USB/CLKO: DD501.5 (CLKO), U203.J16 (IO_L43N_GCLK4_M1DQ5_1)
/USB/D_N: DD501.16 (D-), P501.2 (D-)
/USB/D_P: DD501.15 (D+), P501.3 (D+)
/USB/FD0: DD501.25 (FD0), U203.H16 (IO_L37N_A6_M1A1_1)
/USB/FD1: DD501.26 (FD1), U203.G14 (IO_L36P_A9_M1BA0_1)
/USB/FD2: DD501.27 (FD2), U203.G16 (IO_L36N_A8_M1BA1_1)
/USB/FD3: DD501.28 (FD3), U203.H15 (IO_L37P_A7_M1A0_1)
/USB/FD4: DD501.29 (FD4), U203.P16 (IO_L48N_M1DQ9_1)
/USB/FD5: DD501.30 (FD5), U203.N14 (IO_L45P_A1_M1LDQS_1)
/USB/FD6: DD501.31 (FD6), U203.N16 (IO_L45N_A0_M1LDQSN_1)
/USB/FD7: DD501.32 (FD7), U203.M15 (IO_L46P_FCS_B_M1DQ2_1)
/USB/FD8: DD501.52 (FD8), U203.M16 (IO_L46N_FOE_B_M1DQ3_1)
/USB/FD9: DD501.53 (FD9), U203.L16 (IO_L47N_LDC_M1DQ1_1)
/USB/FD10: DD501.54 (FD10), U203.L14 (IO_L47P_FWE_B_M1DQ0_1)
/USB/FD11: DD501.55 (FD11), U203.K16 (IO_L44N_A2_M1DQ7_1)
/USB/FD12: DD501.56 (FD12), U203.K15 (IO_L44P_A3_M1DQ6_1)
/USB/FD13: DD501.1 (FD13), U203.C15 (IO_L33P_A15_M1A10_1)
/USB/FD14: DD501.2 (FD14), U203.C16 (IO_L33N_A14_M1A4_1)
/USB/FD15: DD501.3 (FD15), U203.E15 (IO_L34P_A13_M1WE_1)
/USB/FIFOADR0: DD501.44 (PA4/FIFOADR0), U203.T14 (IO_L51P_M1DQ12_1)
/USB/FIFOADR1: DD501.45 (PA5/FIFOADR1), U203.T13 (IO_L51N_M1DQ13_1)
/USB/FLAGA: DD501.36 (FLAGA/CTL0), U203.P15 (IO_L48P_HDC_M1DQ8_1)
/USB/FLAGB: DD501.37 (FLAGB/CTL1), U203.R16 (IO_L49N_M1DQ11_1)
/USB/FLAGC: DD501.38 (FLAGC/CTL2), U203.R15 (IO_L49P_M1DQ10_1)
/USB/FX2_LED: DD501.41 (PA1/INT1#), R510.2
/USB/IFCLK: DD501.20 (IFCLK), U203.F16 (IO_L35N_A10_M1A2_1)
/USB/INT0: DD501.40 (PA0/INT0#), R511.2, U203.T15 (IO_L50N_M1UDQSN_1)
/USB/PKTEND: DD501.46 (PA6/PKTEND), U203.R12 (IO_L52P_M1DQ14_1)
/USB/SCL: DD501.22 (SCL), R507.2, U501.6 (SCL)
/USB/SDA: DD501.23 (SDA), JP501.2, R508.2
/USB/SLCS: DD501.47 (PA7/*FLAGD/SLCS#), U203.T12 (IO_L52N_M1DQ15_1)
/USB/SLOE: DD501.42 (PA2/*SLOE), U203.R14 (IO_L50P_M1UDQS_1)
/USB/SLRD: DD501.8 (SLRD/RDY0), U203.E16 (IO_L34N_A12_M1BA2_1)
/USB/SLWR: DD501.9 (SLWR/RDY1), U203.F15 (IO_L35P_A11_M1A7_1)
/USB/VBUS_DET: JP502.1, P501.1 (VCC), R505.2
/USB/VBUS_DET_3V3: C526.1, DD501.43 (PA3/*WU2), R505.1, R509.2
/USB/XTAL_IN: C502.1, DD501.12 (XIN), Y501.1
/USB/XTAL_OUT: C503.1, DD501.11 (XOUT), Y501.2
/USB/unfil_5V: D501.1, FB501.1, JP502.2, P502.1 (VCC)
ADC_OEB_A: U203.B5 (IO_L2P_0); also elsewhere on the board
ADC_OTR_A: U203.A4 (IO_L1N_VREF_0); also elsewhere on the board
ADC_PWDN_A: U203.A5 (IO_L2N_0); also elsewhere on the board
FPGA_ENC_A: U203.A11 (IO_L39N_0); also elsewhere on the board
FPGA_ENC_B: U203.B10 (IO_L35P_GCLK17_0); also elsewhere on the board
FPGA_ENC_SW: U203.A10 (IO_L35N_GCLK16_0); also elsewhere on the board
FPGA_RF_0: U203.B12 (IO_L62P_0); also elsewhere on the board
FPGA_RF_1: U203.A12 (IO_L62N_VREF_0); also elsewhere on the board
FPGA_RF_2: U203.C13 (IO_L63P_SCP7_0); also elsewhere on the board
FPGA_RF_3: U203.A13 (IO_L63N_SCP6_0); also elsewhere on the board
FPGA_RF_4: U203.B14 (IO_L65P_SCP3_0); also elsewhere on the board
FPGA_RF_5: U203.A14 (IO_L65N_SCP2_0); also elsewhere on the board
FPGA_RF_6: U203.B15 (IO_L29P_A23_M1A13_1); also elsewhere on the board
FPGA_RF_7: U203.B16 (IO_L29N_A22_M1A14_1); also elsewhere on the board
GND: C501.1, C502.2, C503.2, C504.1, C505.2, C506.2, C507.2, C508.2, C509.2, C510.2, C511.2, C512.2, C513.2, C514.2, C515.2, C516.2, C517.2, C518.2, C519.2, C520.2, C521.2, C522.2, C523.2, C524.2, C525.2, C526.2, C527.1, D501.2, DD501.4 (GND), DD501.7 (GND), DD501.13 (AGND), DD501.17 (AGND), DD501.19 (GND), DD501.33 (GND), DD501.35 (GND), DD501.48 (GND), P501.5 (GND), P502.5 (GND), R501.1, R504.2, R506.2, R509.1, R512.1, R513.1, SW501.1, U501.2 (A1), U501.3 (A2), U501.4 (GND); also elsewhere on the board
LADC_CLK: U203.A6 (IO_L4N_0); also elsewhere on the board
LADC_CS: U203.B6 (IO_L4P_0); also elsewhere on the board
LADC_DI: U203.A7 (IO_L6N_0); also elsewhere on the board
LADC_DO: U203.C6 (IO_L7N_0); also elsewhere on the board
LDAC_CLK: U203.C8 (IO_L38N_VREF_0); also elsewhere on the board
LDAC_CS: U203.A9 (IO_L34N_GCLK18_0); also elsewhere on the board
LDAC_DI: U203.A8 (IO_L33N_0); also elsewhere on the board
LDAC_LD: U203.B8 (IO_L33P_0); also elsewhere on the board
unnamed: C504.2, P501.6 (shield), R501.2
unnamed: C505.1, DD501.49 (~RES), R502.2, SW501.2
unnamed: C527.2, P502.6 (shield), R512.2
unnamed: D502.1 (K), R510.1
unnamed: D503.1 (K), R511.1
unnamed: DD501.21 (RESRV), R504.1
unnamed: DD501.51 (WAKE), R503.2
unnamed: JP501.1, U501.5 (SDA)
unnamed: JP503.2, R506.1, U501.7 (WP)
unnamed: R513.2, U203.C4 (IO_L1P_HSWAPEN_0)

Notes on the sheet:
Protect AGND
24M, 12p loading 100ppm 500uW drive
IFCLK:FIFO Sync from FPGA CLKO: can be Z
Consider adding 75ohm series res
