licheegh/LCSDR/hardware/main/main.kicad_pcb

## KiCad design hardware/main/main.kicad_pcb (continued)

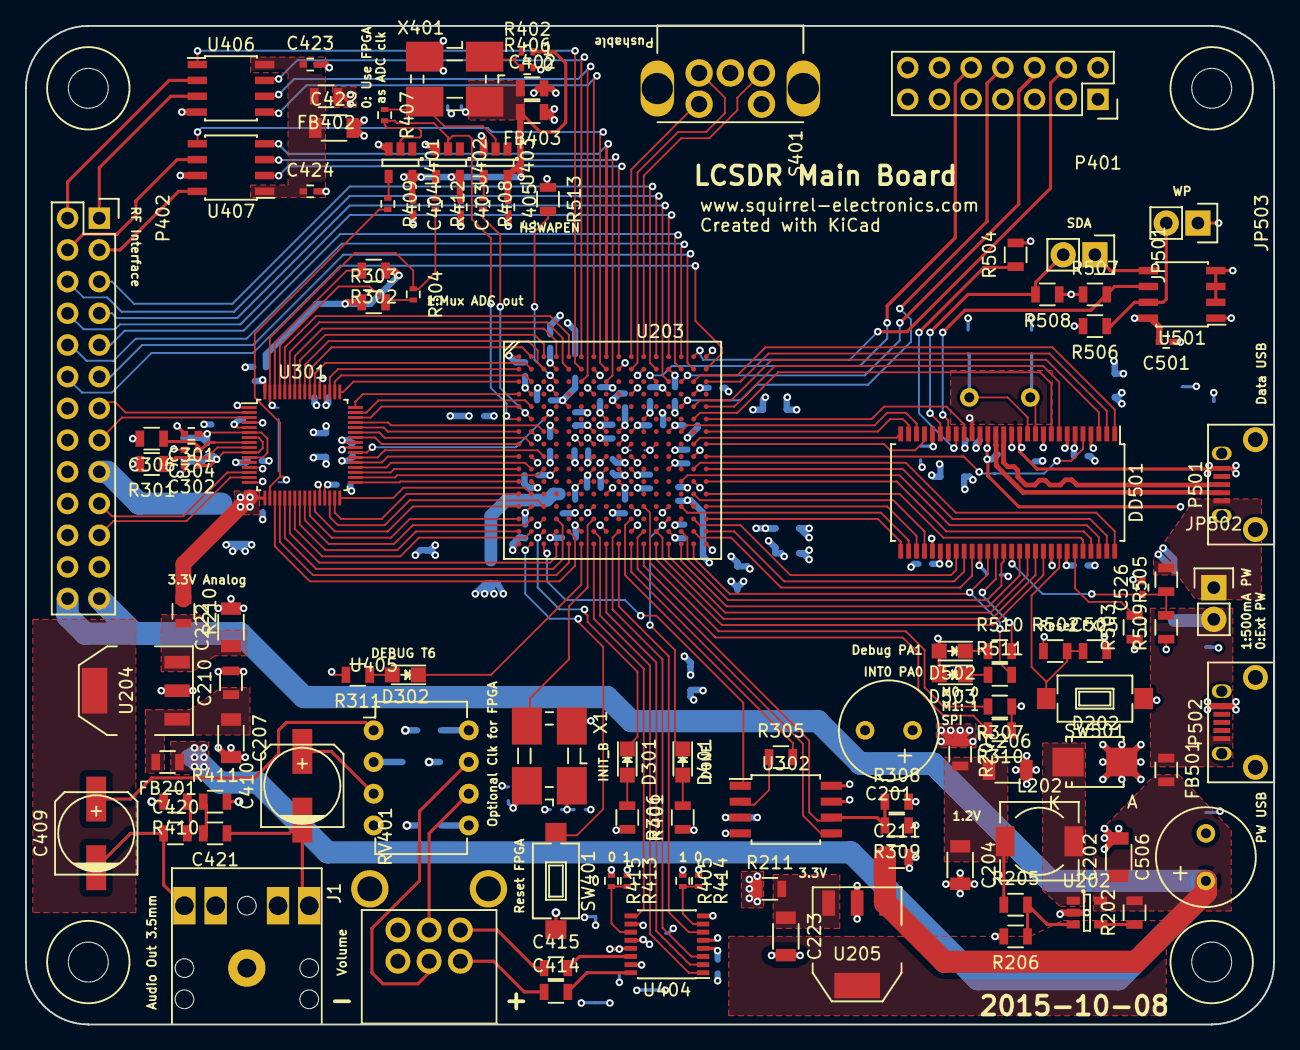
[picture p5: board main.kicad_pcb from above]

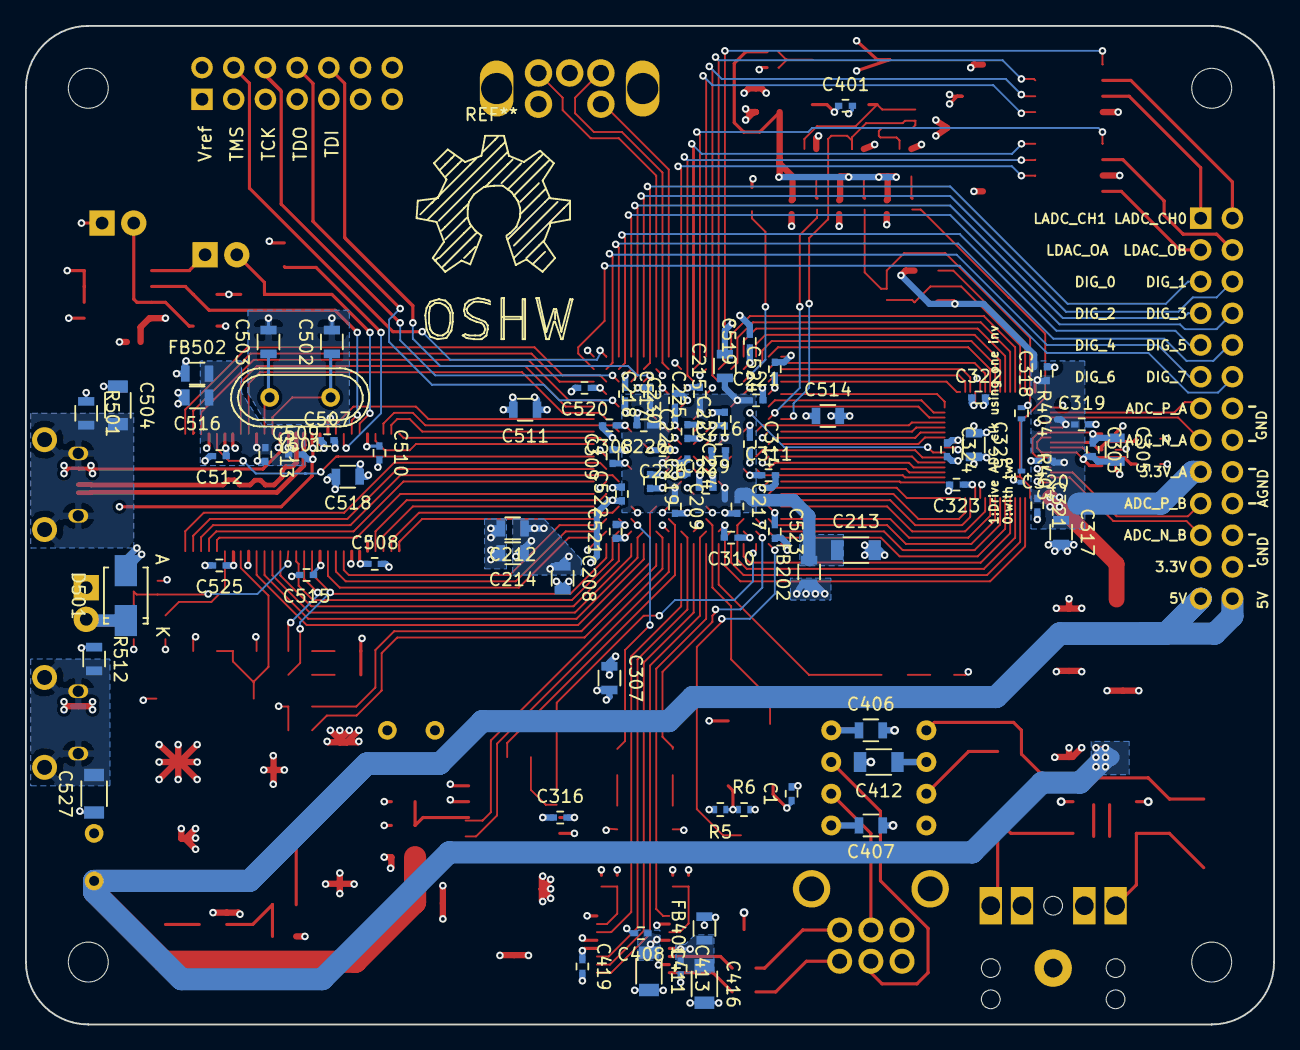
[picture p6: board main.kicad_pcb from below]

Board: 4 copper layers, 100.0 x 80.0 mm, 196 parts (81 on the bottom side), 187 nets.
