licheegh/LCSDR/software/fpga/fifo_512x8.v

//`timescale 1ns / 1ps
// width = 8
// depth = 512
// depth_log2 = 9
// is_async_fifo = 0
// is_sync_read = 1
// is_read_without_pop = 0
// is_multi_pop = 0
// is_write_commit = 0
// is_flush = 1
module fifo_512x8 (
 din
, write_busy
, fifo_full
, dout
, read_busy
, fifo_empty
, fifo_clk
, reset_
, fifo_flush
);

//INPUT ports
input [16-1:0] din;
input write_busy;
input read_busy;
input fifo_clk;
input reset_;
input fifo_flush;

//OUTPUT ports
output [16-1:0] dout;
output fifo_empty;
output fifo_full;

reg  [16-1:0] dout;
reg  fifo_full;
reg  fifo_empty;

reg  [9:0] write_occupancy;
reg  [9:0] read_occupancy;
reg  [9:0] next_write_occupancy;
reg  [9:0] next_read_occupancy;
wire [8:0] next_write_ptr;
reg  [8:0] write_ptr;
wire [8:0] next_read_ptr;
reg  [8:0] read_ptr;
reg  [16-1:0] data_array[512-1:0];
wire [8:0] read_index;
wire [16-1:0] dout_next;
reg  write_busy_d;

always @(posedge fifo_clk or negedge reset_) begin
	if (!reset_) begin 
		write_ptr <= 9'b0;
	end else begin 
		write_ptr <= next_write_ptr;
	end 
end // always posedge ..

//Calculate next write pointer value
assign next_write_ptr =  fifo_flush ? 9'b0 : (write_ptr + (write_busy & ~fifo_full));

always @(posedge fifo_clk or negedge reset_) begin
	if (!reset_) begin 
       		read_ptr <= 9'b0;
  	end else begin  
		read_ptr <= next_read_ptr;
	end 
	
end // always posedge ..

//Calculate next read pointer value
assign next_read_ptr = fifo_flush ? 9'b0 : (read_ptr + (read_busy & ~fifo_empty));

// Read correct memory location
assign read_index[9-1:0] = read_busy ? next_read_ptr : read_ptr;

//Write data into memory
always @(posedge fifo_clk)
	if (write_busy )
		data_array[write_ptr] <= din;
	
//Read memory data
always @(posedge fifo_clk) begin
	dout <= dout_next; 
end

assign dout_next = {data_array[read_index[9-1:0]]};

always @(posedge fifo_clk or negedge reset_) begin
	if (!reset_) begin 
		write_occupancy <= 9'b0;
	end else begin 
		write_occupancy <= next_write_occupancy;
	end 
end

always @(posedge fifo_clk or negedge reset_) begin
	if (!reset_) begin 
		read_occupancy <= 9'b0;
	end else begin 
		read_occupancy <= next_read_occupancy;
	end 
end

always @(posedge fifo_clk or negedge reset_) begin
        if(!reset_) begin 
                write_busy_d <= 1'b0;
        end else begin  
                write_busy_d <= write_busy;
        end 
end

always @(*) begin
	if (fifo_flush) begin 
		next_read_occupancy = 9'b0; 
	end else begin 
		case ({write_busy_d,read_busy})
			2'b00: 	next_read_occupancy = read_occupancy;
			2'b01:	next_read_occupancy = read_occupancy - 1;
			2'b10:  next_read_occupancy = read_occupancy + 1;
			2'b11: 	next_read_occupancy = read_occupancy;
			default:   next_read_occupancy = read_occupancy;
		endcase	
	end 
end

always @(*) begin
	if (fifo_flush) begin 
		next_write_occupancy = 9'b0; 
	end else begin 
		case ({write_busy,read_busy})
			2'b00: 	next_write_occupancy = write_occupancy;
			2'b01:	next_write_occupancy = write_occupancy - 1;
			2'b10: 	next_write_occupancy = write_occupancy + 1;
			2'b11: 	next_write_occupancy = write_occupancy;
			default:   next_write_occupancy = write_occupancy;
		endcase
	end 
end
	
always @(posedge fifo_clk or negedge reset_) begin
		if (!reset_)
			fifo_full <= 0;
		else if (next_write_occupancy == 512)
			fifo_full <= 1;
		else 
			fifo_full <= 0; 
end

always @(posedge fifo_clk or negedge reset_) begin
		if (!reset_)
			fifo_empty <= 1;
		else if (next_read_occupancy == 0)
			fifo_empty <= 1;
		else
			fifo_empty <= 0;
end
// synthesis translate_off
always @(posedge fifo_clk) begin
	if (fifo_full && write_busy) begin
		$display("ERROR: %m: Fifo overflow at time %t", $time);
		$finish;
	end
end // always
// synthesis translate_on
// synthesis translate_off
always @(posedge fifo_clk) begin
	if (fifo_empty && read_busy) begin
		$display("ERROR: %m: Fifo underflow at time %t", $time);
		$finish;
	end
end // always
// synthesis translate_on
endmodule
