licheegh/LCSDR/software/fpga/clk_div_tb.v

`timescale 1ns / 1ps

////////////////////////////////////////////////////////////////////////////////
// Company: 
// Engineer:
//
// Create Date:   17:33:54 10/19/2015
// Design Name:   clk_div
// Module Name:   D:/work/LCSDR/src/xilinx/main1//clk_div_tb.v
// Project Name:  main1
// Target Device:  
// Tool versions:  
// Description: 
//
// Verilog Test Fixture created by ISE for module: clk_div
//
// Dependencies:
// 
// Revision:
// Revision 0.01 - File Created
// Additional Comments:
// 
////////////////////////////////////////////////////////////////////////////////

module clk_div_tb;

	// Inputs
	reg clk_in;

	// Outputs
	wire clk_out;

	// Instantiate the Unit Under Test (UUT)
	clk_div uut (
		.clk_in(clk_in), 
		.clk_out(clk_out)
	);

	initial begin
		// Initialize Inputs
		clk_in = 0;

		// Wait 100 ns for global reset to finish
		#100;
        
		// Add stimulus here

	end
      
    parameter PERIOD = 1000/3.125;

    always begin
        clk_in = 1'b0;
        #(PERIOD/2) clk_in = 1'b1;
        #(PERIOD/2);
    end       
endmodule
