licheegh/LCSDR/(commit log)

2015-11-01 to public
    [ADC.sch, Clock.sch, FPGA_LOGIC.sch, PSU.sch, USB.sch, bom.ods, etc.sch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]
2018-01-17 add software things.
    It is not release ready yet.But people can reference to it.
    [ADC.sch, Clock.sch, FPGA_LOGIC.sch, PSU.sch, USB.sch, bom.ods, etc.sch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]
