licheegh/LCSDR/(notices)

Notices in the files:
software/python/test_usb1.py:
This program is free software; you can redistribute it and/or modify
it under the terms of the GNU General Public License as published by
the Free Software Foundation; either version 2, or (at your option)
